jsa-m/Digital-Multi-Functional-Thermometer/README.md

# Digital-Multi-Functional-Thermometer

This thermometer provides instant digital readout of the temperature sensed by a K type thermocouple. It can measure temperatures precisely between 20 and 250 ºC (68 ºF and 482 ºF). This appliance is useful for both beginners and professional cookers to monitor the internal temperature of foods like steaks, chicken, fish and liquids like water or cooking oil.

<p align="center">
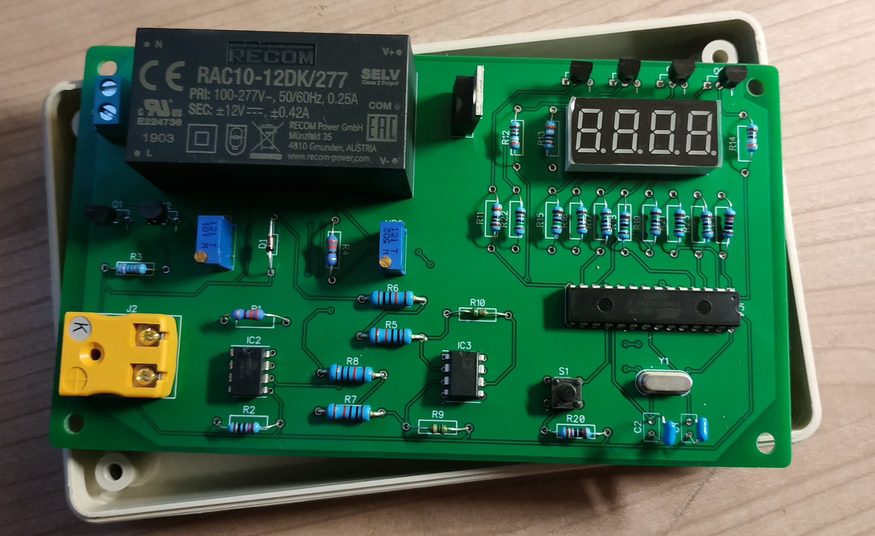
[picture p1: pcb.jpg]

</p>
