jsa-m/Digital-Multi-Functional-Thermometer/Diagrams/PCB_BOM.pdf

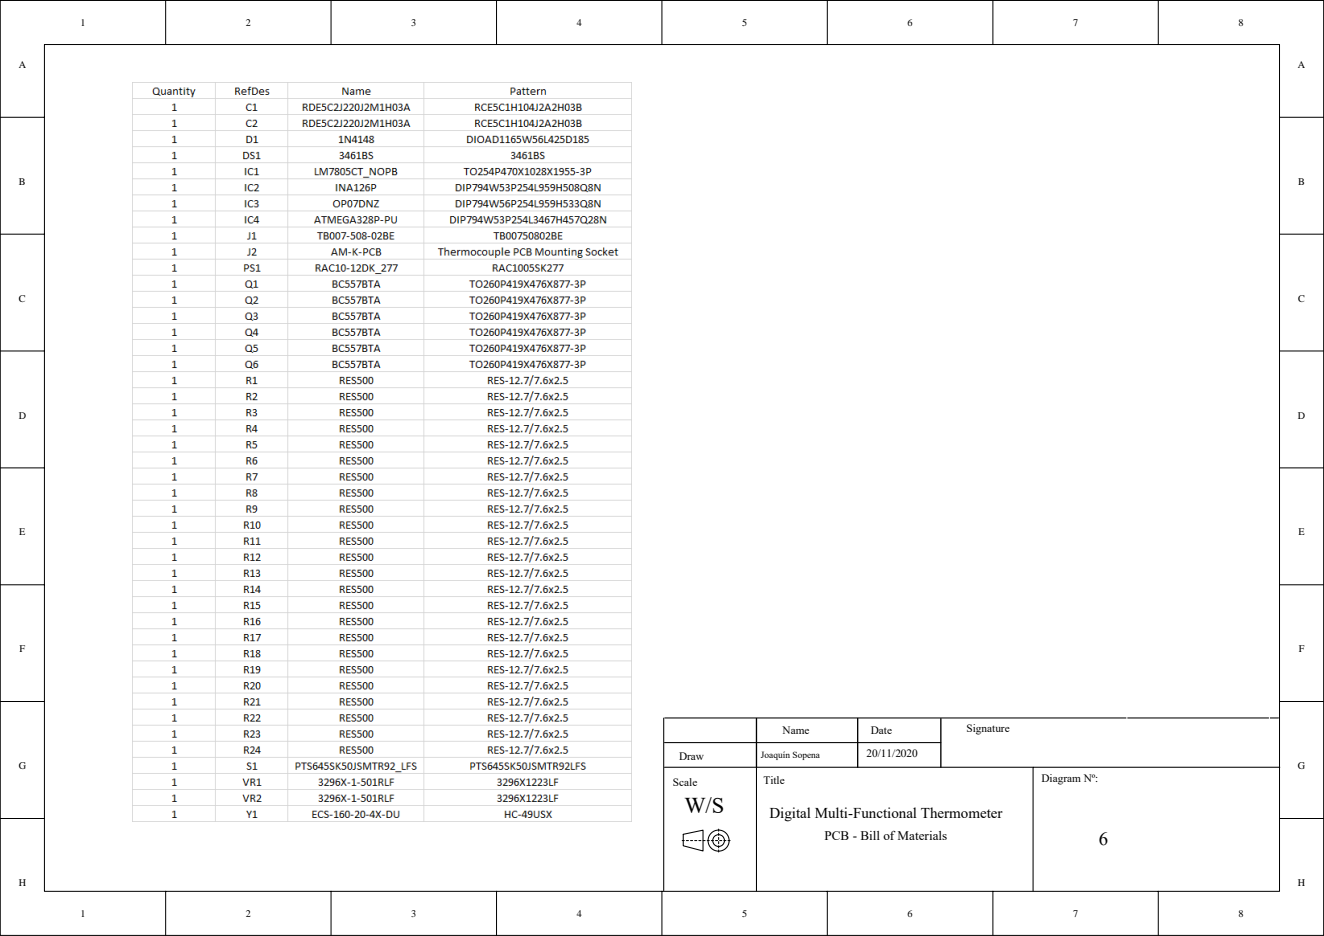
[picture p17: page 1]
Draw; Scale; Name; Date; Signature; Title; Diagram Nº:

Joaquín Sopena
Digital Multi-Functional Thermometer

PCB - Bill of Materials
