jsa-m/Digital-Multi-Functional-Thermometer/Diagrams/CircuitDiagram.pdf

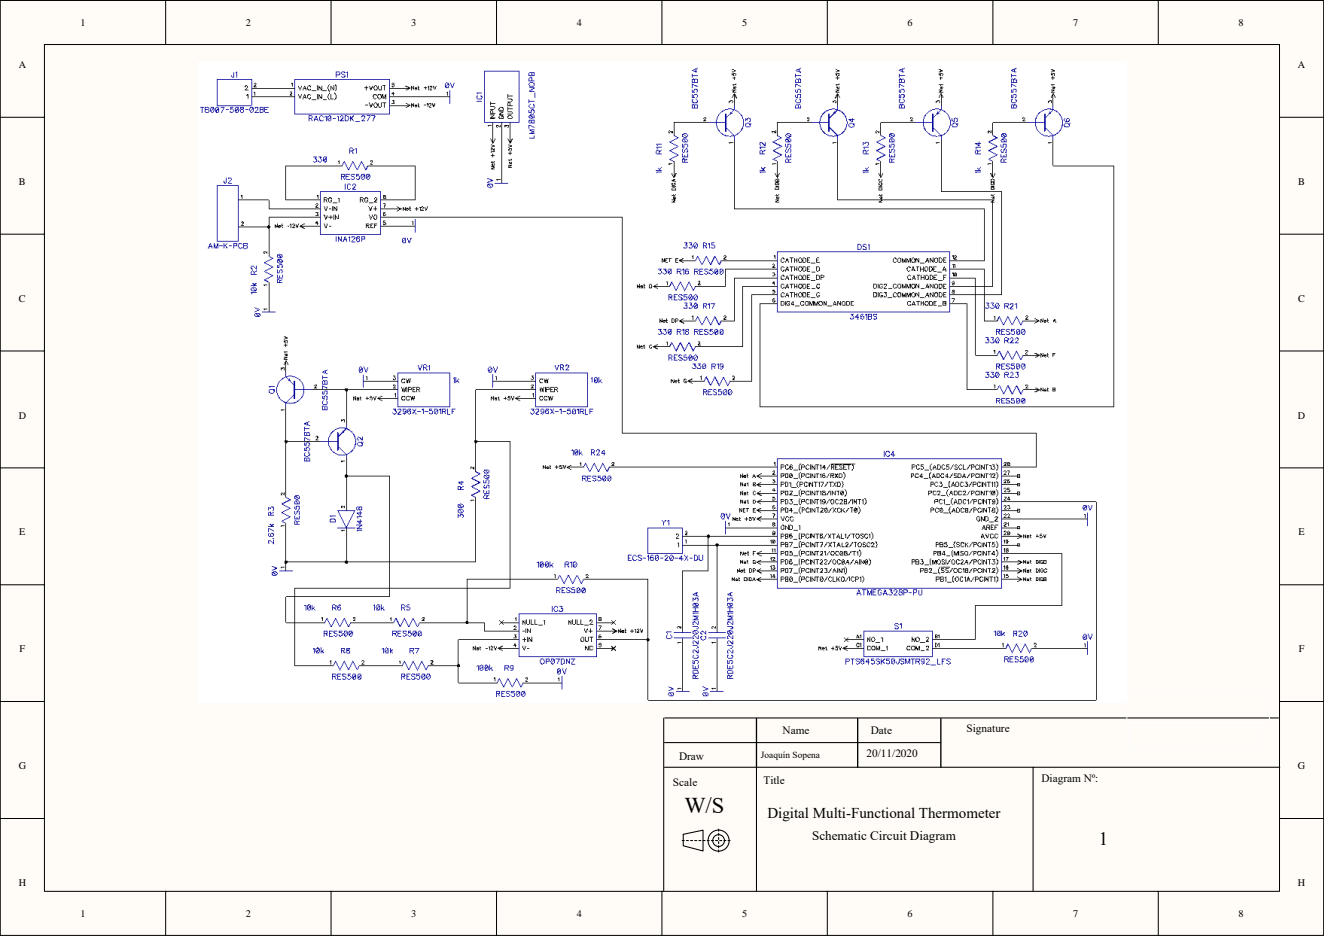
[picture p18: page 1]
Draw; Scale; Name; Date; Signature; Title; Diagram Nº:

Joaquín Sopena
Digital Multi-Functional Thermometer
Schematic Circuit Diagram
