jsa-m/Digital-Multi-Functional-Thermometer/Diagrams/PCB_BOTTOM.pdf

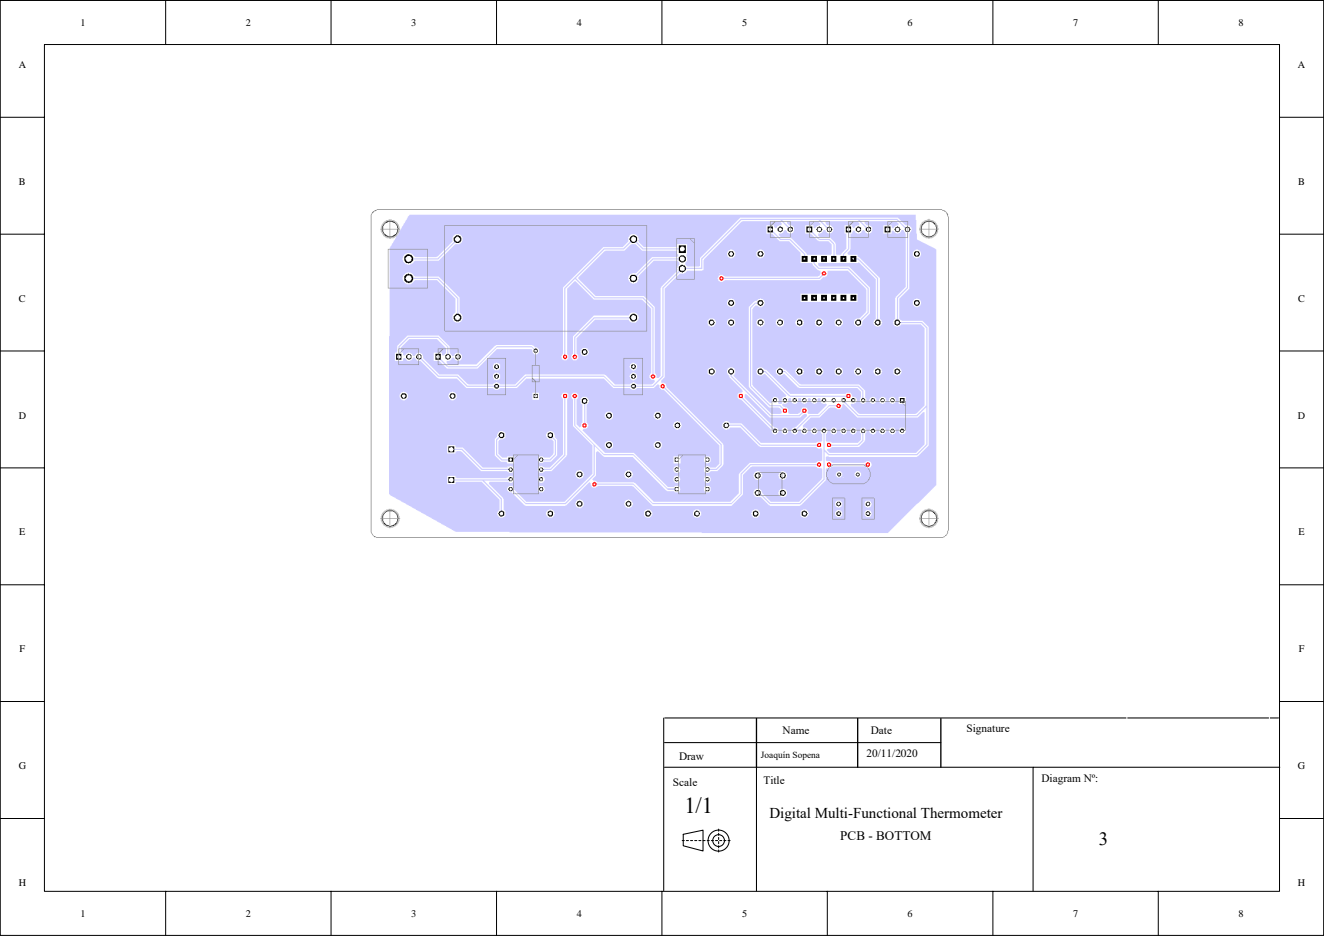
[picture p19: page 1]
Draw; Scale; Name; Date; Signature; Title; Diagram Nº:; PCB - BOTTOM

Joaquín Sopena
Digital Multi-Functional Thermometer
