jsa-m/Digital-Multi-Functional-Thermometer/Diagrams/PCB_TOP.pdf

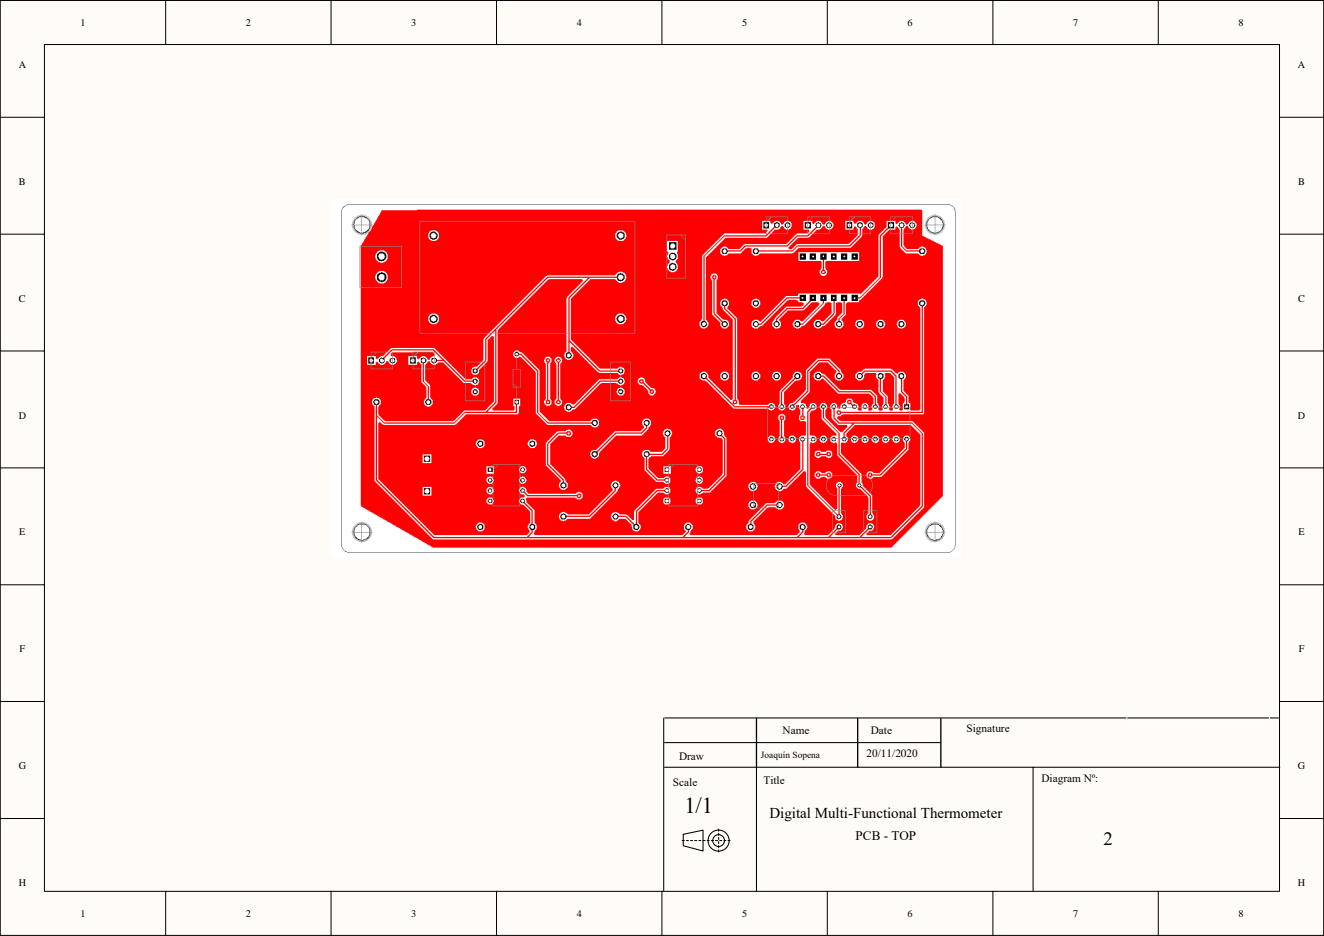
[picture p20: page 1]
Draw; Scale; Name; Date; Signature; Title; Diagram Nº:; PCB - TOP

Joaquín Sopena
Digital Multi-Functional Thermometer
